josephborromeo/WiCAN/README.md

# WiCAN
ESP32-S3 Based Wireless CAN bus Transceiver and Logger
