josephborromeo/WiCAN/Hardware/WiCAN_V1/WiCAN_BOM.xlsx

Comment | Description | Designator | Footprint | LibRef | Quantity | Manufacturer_Part_Number | Customer Ref | Mult. Qty | QTY Multiplier | 2.5 | WiCAN
CL10B104KB8WPNC | Cap Ceramic 100nF 50V X7R ±10% Pad SMD 0603 +125°C T/R | C1, C4, C10, C11 | FP-CL10-IPC_A | CMP-13271-002353-1 | 4 | CL10B104KB8WPNC | WiCAN C1, C4, C10, C11 | 10
UMK107BJ105KA-T | None | C2 | FP-0603-L_1_6_0_1-W_0_8_0-IPC_A | CMP-2000-05447-3 | 1 | UMK107BJ105KA-T | WiCAN C2 | 3
GRM188R61A226ME15D | Chip Multilayer Ceramic Capacitors for General Purpose, 0603, 22uF, X5R, 15%, 20%, 10V | C3 | FP-GRM188-0_2-IPC_C | CMP-2000-06337-3 | 1 | GRM188R61A226ME15D | WiCAN C3 | 3
CL10A106MQ8NNNC | Cap Ceramic 10uF 6.3V X5R ±20% Pad SMD 0603 +85°C T/R | C5, C6, C8 | FP-CL10-IPC_C | CMP-13271-001938-1 | 3 | CL10A106MQ8NNNC | WiCAN C5, C6, C8 | 8
GRM188R60G226MEA0D | Chip Multilayer Ceramic Capacitors for General Purpose, 0603, 22uF, X5R, 15%, 20%, 4V | C7 | FP-GRM188-0_2-MFG | CMP-2006-02788-2 | 1 | GRM188R60G226MEA0D | WiCAN C7 | 3
CL10A105KO8NNNC | Cap Ceramic 1uF 16V X5R ±10% Pad SMD 0603 +85°C T/R | C9 | FP-CL10-IPC_A | CMP-13271-001457-1 | 1 | CL10A105KO8NNNC | WiCAN C9 | 3
MBRX120LF-TP | DIODE SCHOTTKY 20V 1A SOD123 | D1 | FP-SOD-123-IPC_A | CMP-56206-000012-1 | 1 | MBRX120LF-TP | WiCAN D1 | 3
PESD2CANFD24U-TR | Diode | D2 | SOT95P230X110-3N | PESD2CANFD24U-TR | 1 | PESD2CANFD24U-TR | WiCAN D2 | 3
12V | LED GREEN CLEAR CHIP SMD | D3 | FP-LTST-C190KGKT-MFG | CMP-2000-05197-2 | 1 | 160-1435-1-ND | WiCAN D3 | 3
5V | LED GREEN CLEAR CHIP SMD | D4 | FP-LTST-C190KGKT-MFG | CMP-2000-05197-2 | 1 | 160-1435-1-ND | WiCAN D4 | 3
3V3 | LED GREEN CLEAR CHIP SMD | D5 | FP-LTST-C190KGKT-MFG | CMP-2000-05197-2 | 1 | 160-1435-1-ND | WiCAN D5 | 3
USBLC6-2SC6 | Integrated Circuit | IC1 | SOT95P280X145-6N | USBLC6-2SC6 | 1 | USBLC6-2SC6 | WiCAN IC1 | 3
AZ1117IH-5.0TRG1 | Integrated Circuit | IC2 | SOT230P700X170-4N | AZ1117IH-5.0TRG1 | 1 | AZ1117IH-5.0TRG1 | WiCAN IC2 | 3
USB4105-GF-A | No Description Available | J1 | USB4105_GCT | USB4105-GF-A | 1 | 2073-USB4105-GF-ACT-ND | WiCAN J1 | 3
MEM2067-02-180-00-A_REVB | Micro SD Memory Card ConnectorSMT, Hinged, 1.80mm Profile | J2 | GCT_MEM2067-02-180-00-A_REVB | MEM2067-02-180-00-A_REVB | 1 | 2073-MEM2067-02-180-00-ACT-ND | WiCAN J2 | 3
A-DS_09_PP_Z | Connector | J3 | ADS09PPZ | A-DS_09_PP_Z | 1 | A-DS 09 PP/Z | WiCAN J3 | 3
Solder Jumper |  | JMP1 | Solder Jumper | Solder Jumper | 1 |  | WiCAN JMP1 | 3
STATUS | LED | LED1 | CLMVCFKACL1D1L71BB7C3C3 | CLMVC-FKA-CL1D1L71BB7C3C3 | 1 | CLMVC-FKA-CL1D1L71BB7C3C3 | WiCAN LED1 | 3
RMCF0603JG10K0 | 10kΩ ±5% 0.1W 0603 Thick Film Chip Resistor AEC-Q200 compliant | R1, R5, R6, R7, R8, R9, R10 | FP-RMCF0603-MFG | CMP-26527-000153-1 | 7 | RMCF0603JG10K0 | WiCAN R1, R5, R6, R7, R8, R9, R10 | 18
ERJ-3GEYJ620V |  | R2, R4 | RESC1608X55X30ML15T15 | CMP-1012-00045-2 | 2 | ERJ-3GEYJ620V | WiCAN R2, R4 | 5
RMCF0603FT280R | 280Ω ±1% 0.1W 0603 Thick Film Chip Resistor AEC-Q200 compliant | R3, R12 | FP-RMCF0603-MFG | CMP-26527-006784-1 | 2 | RMCF0603FT280R | WiCAN R3, R12 | 5
ESR03EZPJ751 | 750Ω ±5% 0.25W 0603 Anti-Surge Chip Resistor AEC-Q200 | R11 | FP-ESR03-IPC_B | CMP-08839-029062-1 | 1 | ESR03EZPJ751 | WiCAN R11 | 3
AC0603FR-10100RL | RES 100Ω 1.00% 0.1W 0603 | R13 | FP-AC0603-IPC_A | CMP-03412-011629-2 | 1 | AC0603FR-10100RL | WiCAN R13 | 3
ERJ-P06J121V |  | R14 | RESC2013X70X40LL20T20 | CMP-2001-00481-1 | 1 | ERJ-P06J121V | WiCAN R14 | 3
RESET | Switch | S1 | PTS526SKG15SMTR2LFS | PTS526_SK08_SMTR2_LFS | 1 | PTS526 SK08 SMTR2 LFS | WiCAN S1 | 3
BOOT | Switch | S2 | PTS526SKG15SMTR2LFS | PTS526_SK08_SMTR2_LFS | 1 | PTS526 SK08 SMTR2 LFS | WiCAN S2 | 3
ESP32-S3-WROOM-1-N4 | Integrated Circuit | U1 | ESP32S3WROOM1N4 | ESP32-S3-WROOM-1-N4 | 1 | ESP32-S3-WROOM-1-N4 | WiCAN U1 | 3
AZ1117CR-3.3TRG1 | IC REG LINEAR 3.3V 800MA SOT89 | U2 | FP-SOT89-MFG | CMP-12756-000007-1 | 1 | AZ1117CR-3.3TRG1 | WiCAN U2 | 3
MCP9700T-E/TT | Low-Power Linear Active Thermistor IC, 3-Pin SOT-23, Extended Temperature, Tape and Reel | U3 | SOT-23-TT3_M | CMP-0192-00220-1 | 1 | MCP9700T-E/TT | WiCAN U3 | 3
SN65HVD232D | 3.3 V CAN Transceiver, 17 mA, -40 to 85 degC, 8-pin SOIC (D), Green (RoHS & no Sb/Br) | U4 | D0008A_L | CMP-0315-00073-2 | 1 | SN65HVD232D | WiCAN U4 | 3
