josephborromeo/WiCAN/Hardware/WiCAN_V2/Enclosure/WiCAN_Enclosure_assy.SLDASM

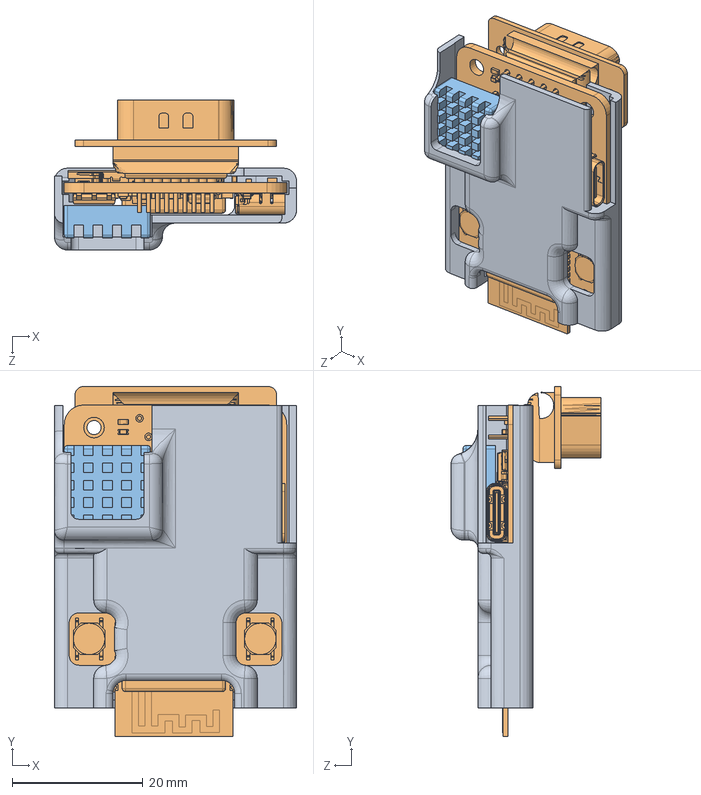
[picture p1: CAD file, 2023-03-30]
Hardware/WiCAN_V2/Enclosure/WiCAN_Enclosure_assy.SLDASM
37.0 x 53.5 x 22.9 mm
WiCAN_Enclosure_Base
WiCAN
Copper_Heatsink
