josephborromeo/WiCAN/Hardware/WiCAN_V2/Enclosure/Copper_Heatsink.SLDPRT

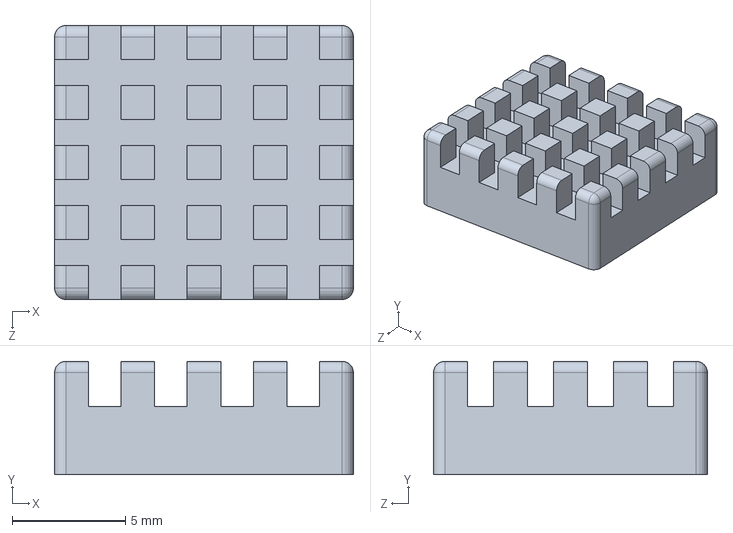
[picture p2: CAD file, 2023-03-30]
Hardware/WiCAN_V2/Enclosure/Copper_Heatsink.SLDPRT
13.2 x 5.00 x 12.1 mm
