josephborromeo/WiCAN/Hardware/WiCAN_V2/Models/MEM2067-02-180-00-A.STEP

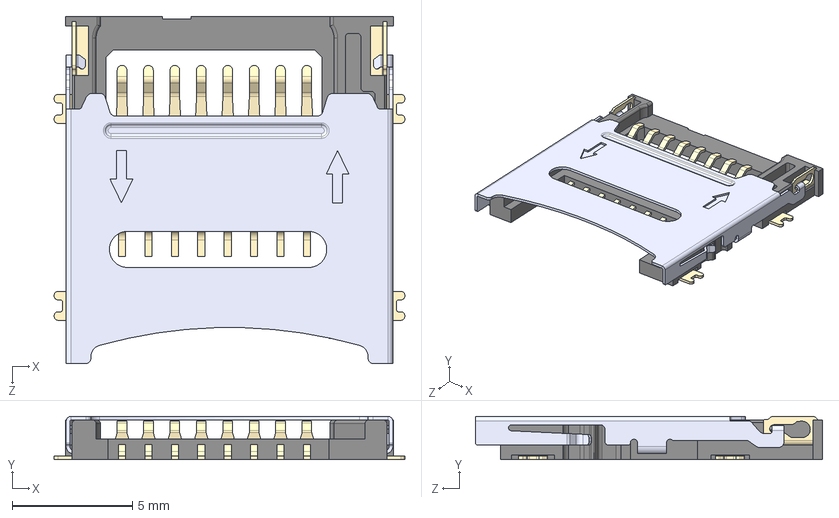
[picture p3: CAD file, 2023-01-06]
Hardware/WiCAN_V2/Models/MEM2067-02-180-00-A.STEP
14.6 x 1.80 x 14.5 mm
