josephborromeo/WiCAN/Hardware/WiCAN_V2/WiCAN_board_outline.dxf

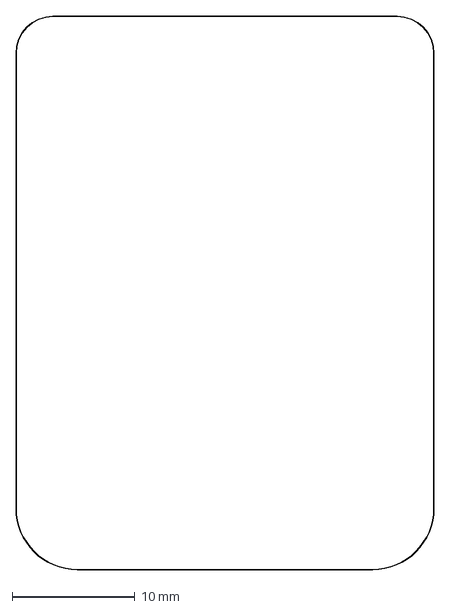
[picture p4: CAD file, 2023-01-06]
Hardware/WiCAN_V2/WiCAN_board_outline.dxf
34.0 x 45.0 mm
