josephborromeo/WiCAN/Hardware/WiCAN_V2/Enclosure/Aluminum_Heatsink.SLDPRT

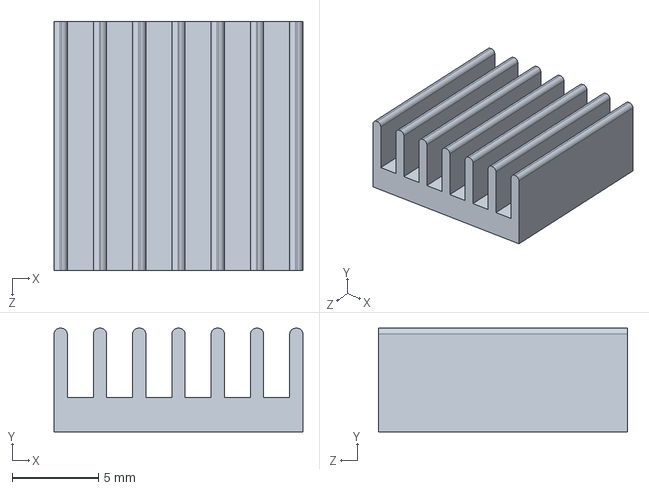
[picture p5: CAD file, 2023-03-30]
Hardware/WiCAN_V2/Enclosure/Aluminum_Heatsink.SLDPRT
14.4 x 6.00 x 14.4 mm
