josephborromeo/WiCAN/Hardware/WiCAN_V2/Models/connector_a-ds_09_pp_z.stp

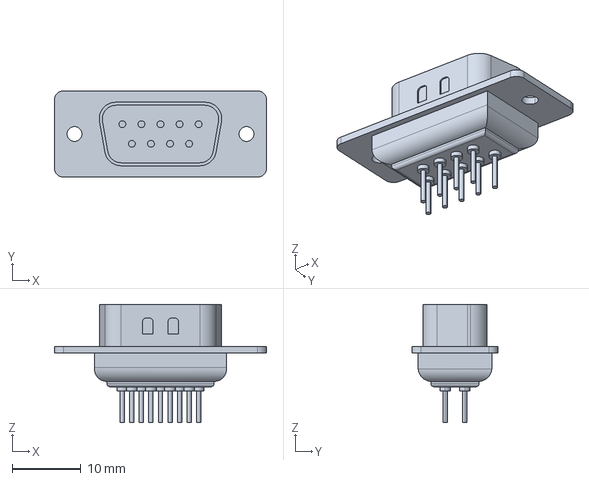
[picture p7: CAD file, 2023-01-06]
Hardware/WiCAN_V2/Models/connector_a-ds_09_pp_z.stp
30.8 x 12.6 x 17.2 mm
