josephborromeo/WiCAN/Hardware/WiCAN_V2/Enclosure/WiCAN_Enclosure_Base.SLDPRT

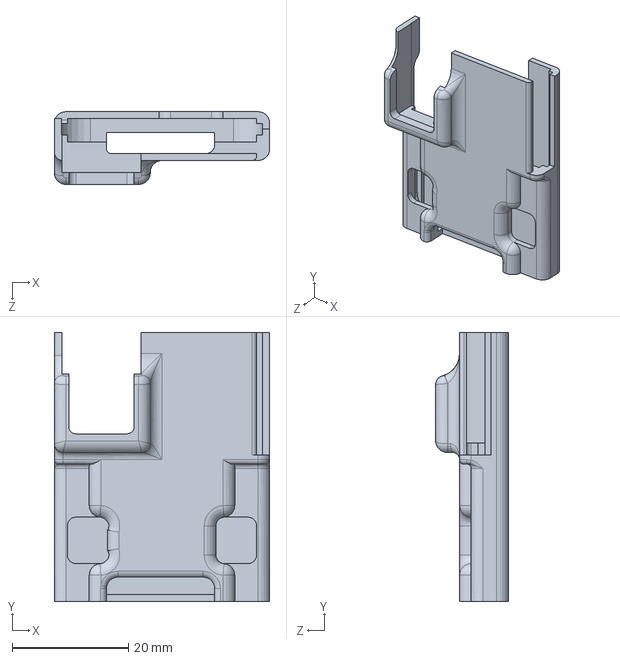
[picture p8: CAD file, 2023-03-30]
Hardware/WiCAN_V2/Enclosure/WiCAN_Enclosure_Base.SLDPRT
37.0 x 46.2 x 12.5 mm
