josephborromeo/WiCAN/Hardware/WiCAN_V2/Models/ESP32-S2-MINI-1-N4.STEP

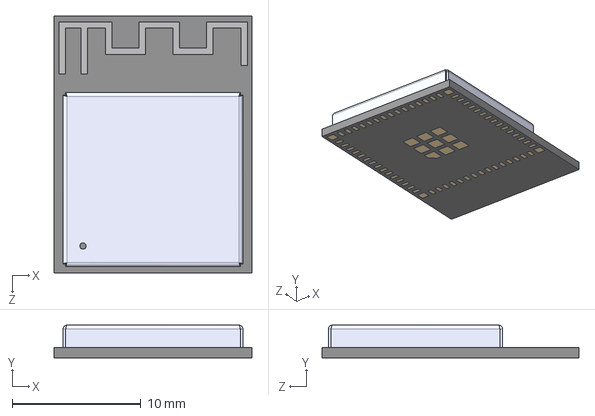
[picture p9: CAD file, 2023-01-06]
Hardware/WiCAN_V2/Models/ESP32-S2-MINI-1-N4.STEP
15.4 x 2.55 x 20.0 mm
