josephborromeo/WiCAN/Hardware/WiCAN_V1/Enclosure/WiCAN_Enclosure_assy.SLDASM

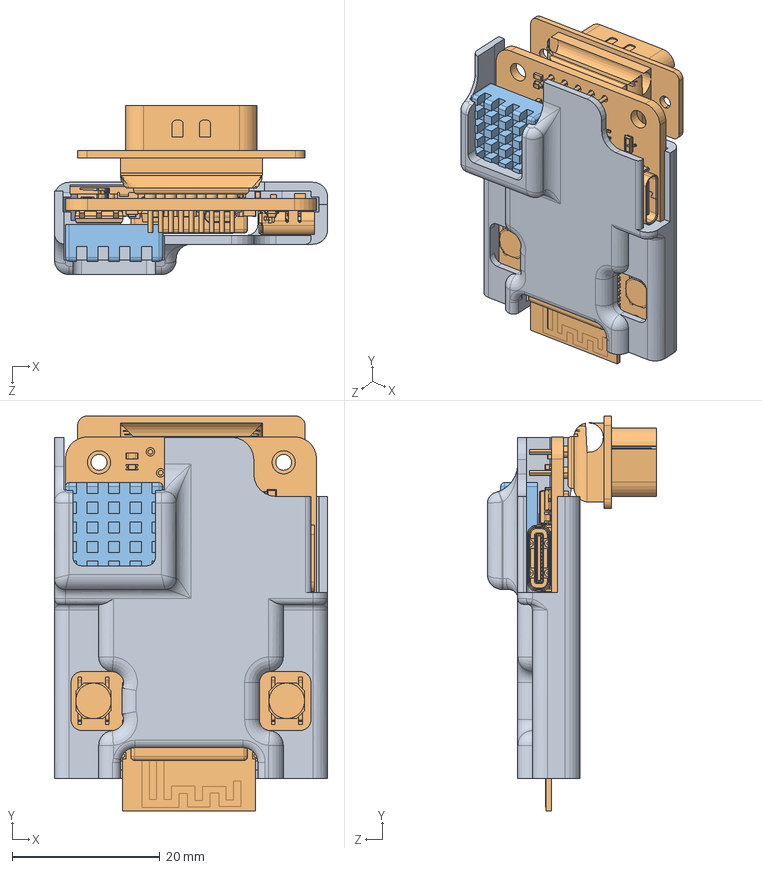
[picture p10: CAD file, 2023-04-18, an earlier design]
Hardware/WiCAN_V1/Enclosure/WiCAN_Enclosure_assy.SLDASM
37.0 x 53.5 x 22.9 mm
WiCAN_Enclosure_Base
WiCAN
Copper_Heatsink
