josephborromeo/WiCAN/Hardware/WiCAN_V1/Enclosure/WiCAN_Enclosure_Base.SLDPRT

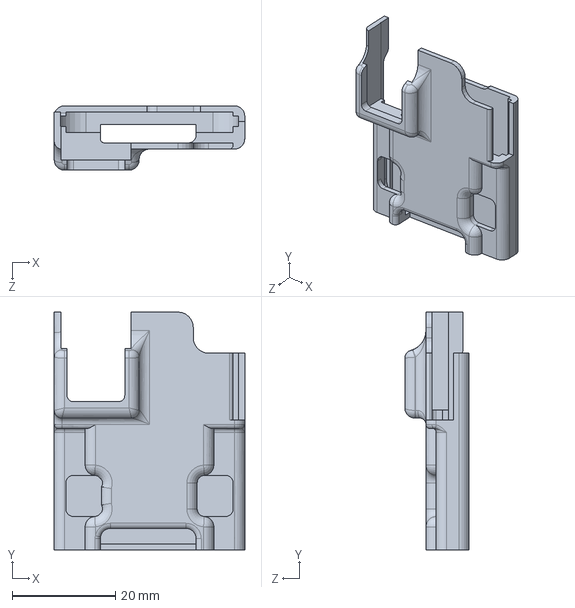
[picture p11: CAD file, 2023-04-18, an earlier design]
Hardware/WiCAN_V1/Enclosure/WiCAN_Enclosure_Base.SLDPRT
37.0 x 46.2 x 12.5 mm
