josephborromeo/WiCAN/(list of files, cad)

Other CAD files:
Hardware/WiCAN_V1/Enclosure/WiCAN_Enclosure_Base.3MF
Hardware/WiCAN_V2/Enclosure/WiCAN_Enclosure_Base.3MF
