josephborromeo/WiCAN/Hardware/WiCAN_V2/WiCAN.pdf

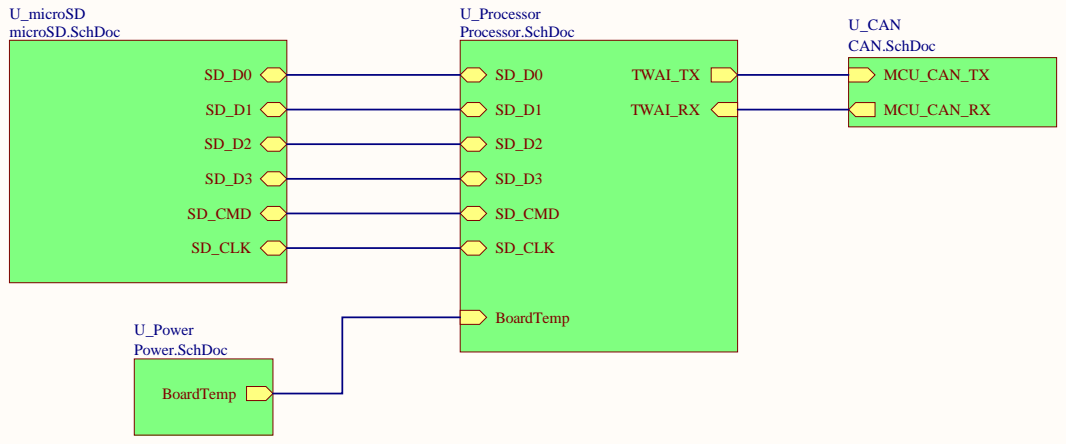
[picture p12: page 1]

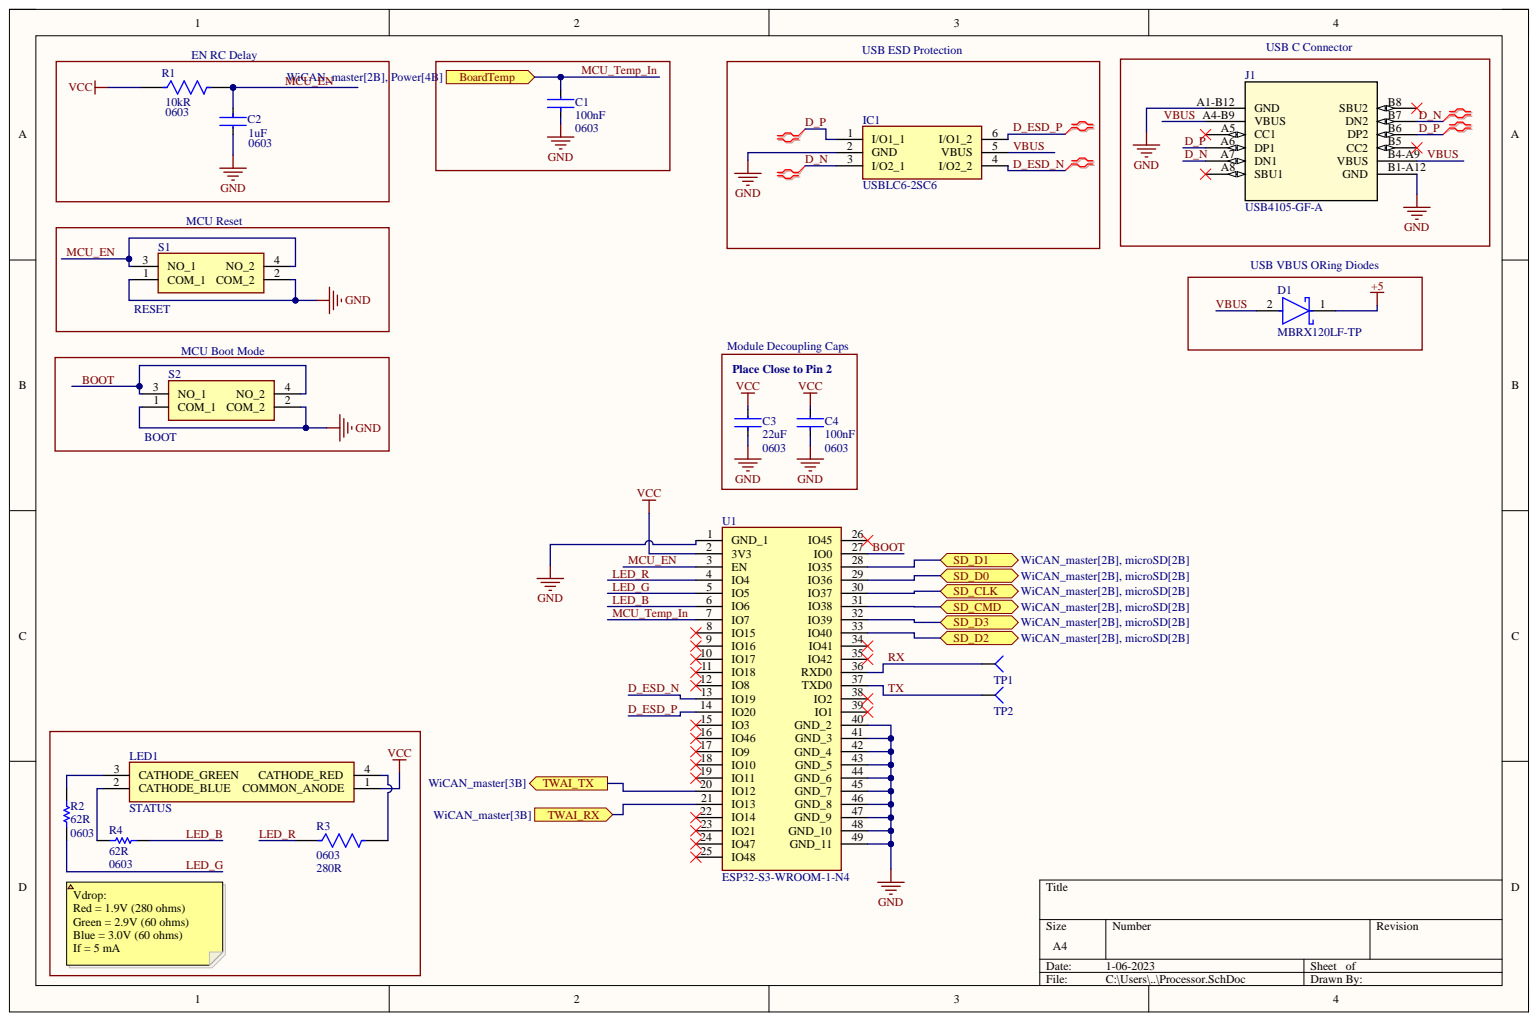
[picture p13: page 2]

USB VBUS ORing Diodes

Place Close to Pin 2

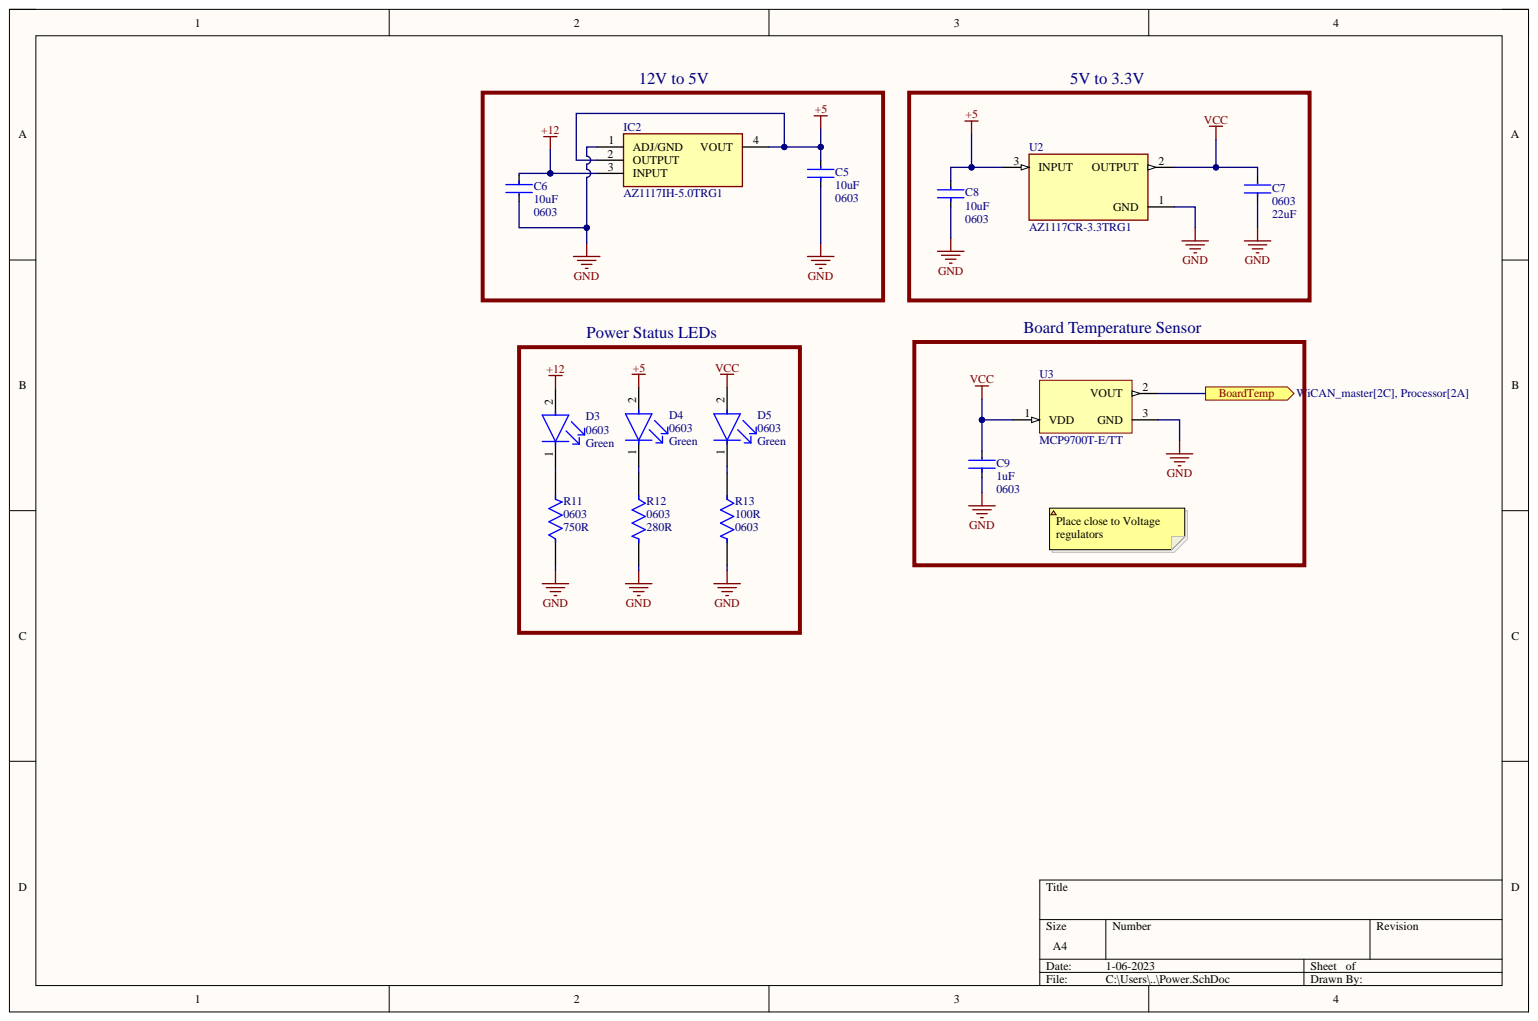
[picture p14: page 3]

Place close to Voltage
regulators

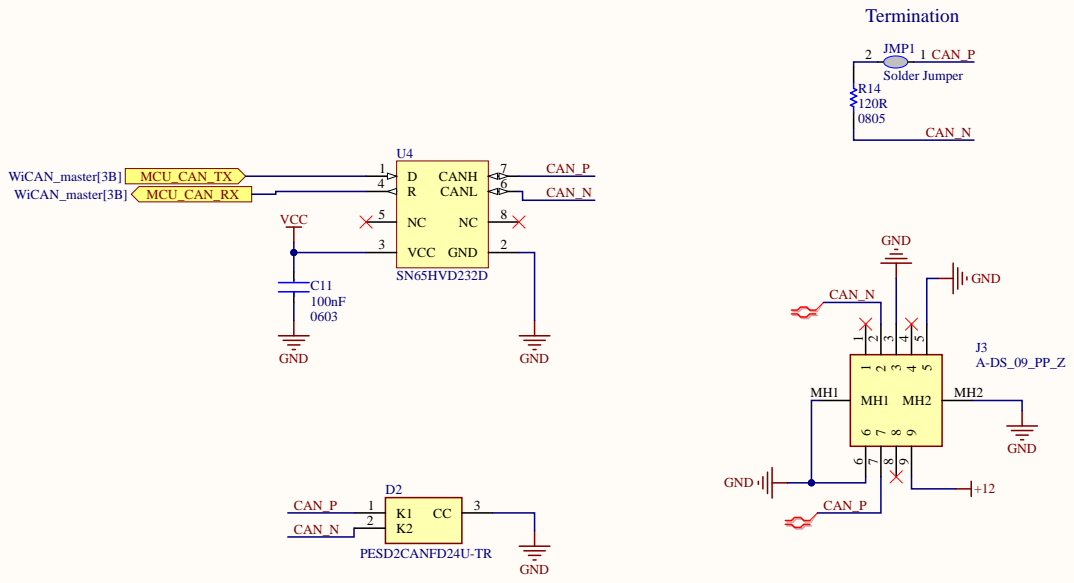
[picture p15: page 4]

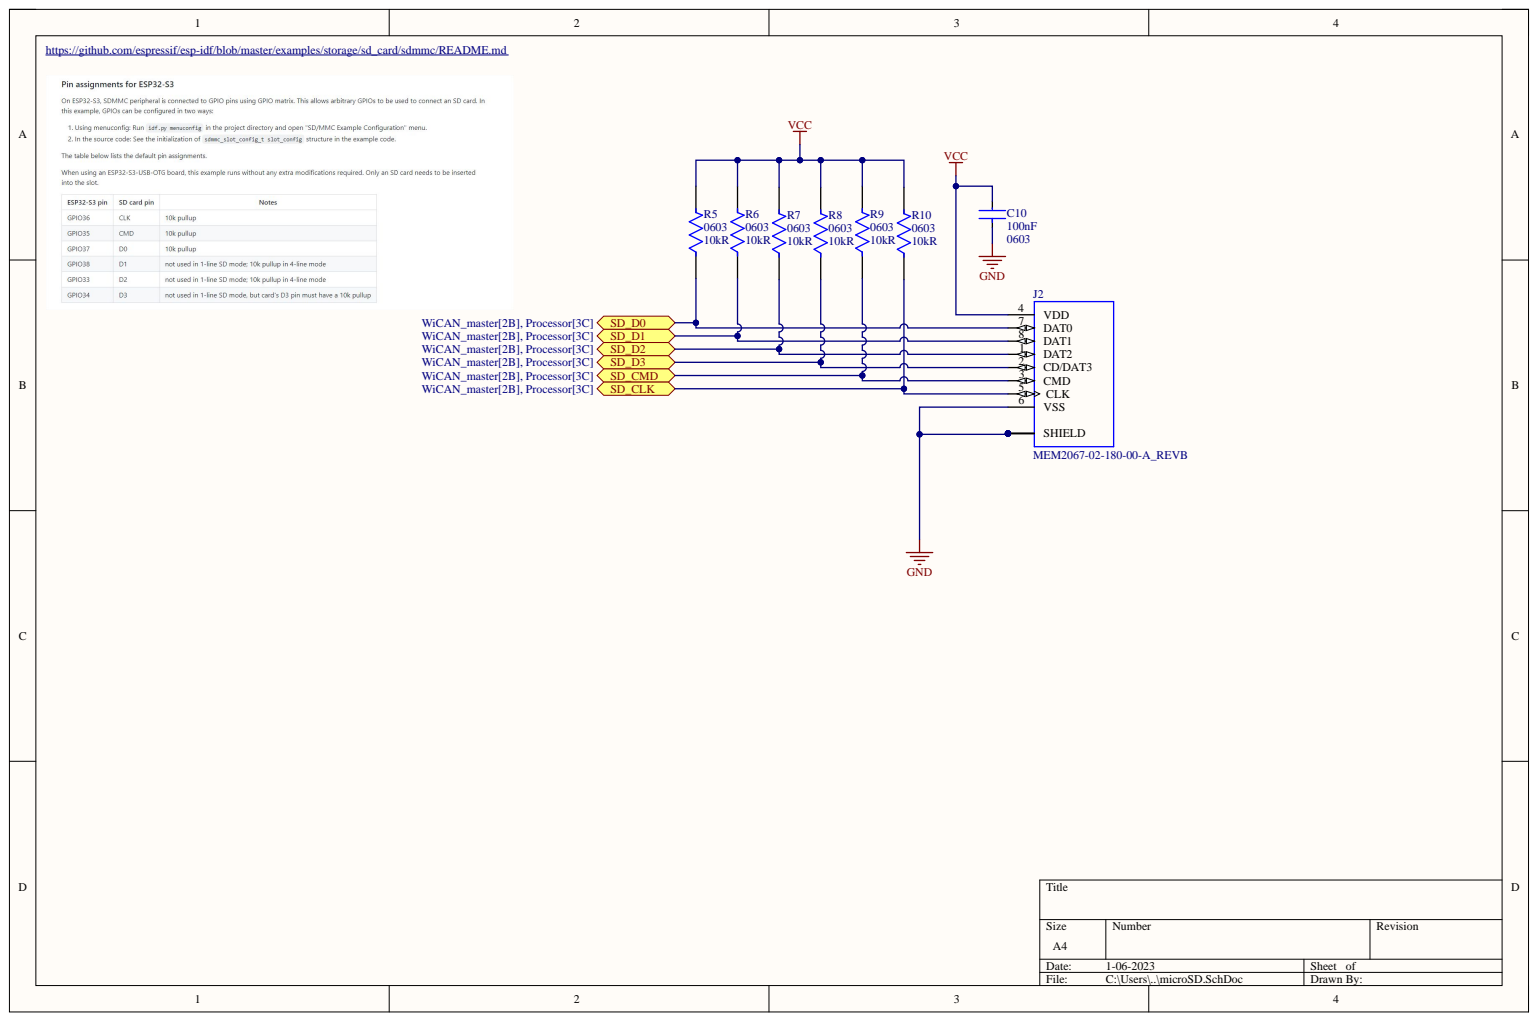
[picture p16: page 5]

https://github.com/espressif/esp-idf/blob/master/examples/storage/sd_card/sdmmc/README.md

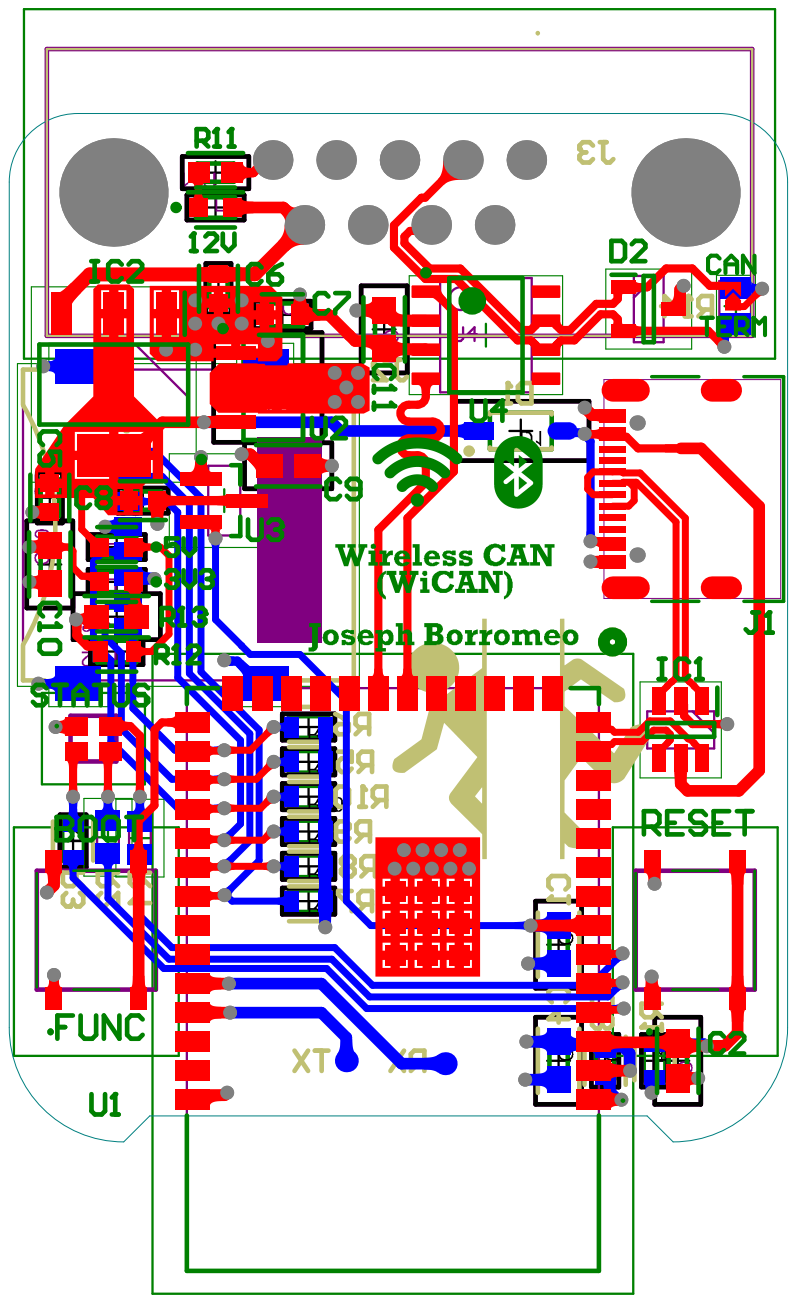
[picture p17: page 6]
