josephborromeo/WiCAN/(list of files, drawings)

Other design files:
Hardware/WiCAN_V1/CAN.SchDoc
Hardware/WiCAN_V1/microSD.SchDoc
Hardware/WiCAN_V1/Power.SchDoc
Hardware/WiCAN_V1/Processor.SchDoc
Hardware/WiCAN_V1/WiCAN.PrjPcb
Hardware/WiCAN_V1/WiCAN_lib.PcbLib
Hardware/WiCAN_V1/WiCAN_lib.SchLib
Hardware/WiCAN_V1/WiCAN_master.SchDoc
Hardware/WiCAN_V2/CAN.SchDoc
Hardware/WiCAN_V2/microSD.SchDoc
Hardware/WiCAN_V2/Power.SchDoc
Hardware/WiCAN_V2/Processor.SchDoc
Hardware/WiCAN_V2/WiCAN.PrjPcb
Hardware/WiCAN_V2/WiCAN_lib.PcbLib
Hardware/WiCAN_V2/WiCAN_lib.SchLib
Hardware/WiCAN_V2/WiCAN_master.SchDoc
