josephborromeo/WiCAN/(commit log)

2023-01-06 Iniital Commit of project files
    [CAN.SchDoc, ESP32-S2-MINI-1-N4.STEP, ESP32-S3-WROOM.step, MEM2067-02-180-00-A.STEP, Power.SchDoc, Processor.SchDoc, WiCAN.PrjPcb, WiCAN_BOM.xlsx]
2023-01-08 LEDC driver and SDMMC driver working
2023-01-28 Fixed SD card mount failure crashing the board. Starting Wifi Setup
    [WiCAN_TX.c, sdmmc_driver.c, wifi.c, wifi.h]
2023-01-31 wireless working - gotta fix ifdefs
    [WiCAN_TX.c, twai_driver.c, wifi.c, wifi.h]
2023-01-31 Fixed conditional compilation for TX and RX boards
    [WiCAN_TX.c, wifi.c]
2023-02-01 Wireless transmission of CAN data successful
2023-02-01 Start of USB driver and CAN messages are wireless
2023-02-10 Fixed some bugs for RX device not initializing correctly if receiving data
    [WiCAN_TX.c, wifi.c, wifi.h]
2023-02-22 wireless CAN is wireless. Trying to get custom USB name now
2023-02-27 Added definition for CAN log format. Added function prototype for logging task
2023-03-15 Transmit CAN from SLCAN to TX board ready for testing
2023-03-15 Wireless CAN messages working!
2023-03-21 SD logging working! Need to fix capital filename/ extension
    [sdmmc_driver.c, sdmmc_driver.h, twai_driver.c]
2023-03-21 Upadted sdkconfig to support long filenames and fix uppercase filenames
    [sdmmc_driver.h]
2023-03-26 trying to fix but where TX crashes with no receivers
    [WiCAN_TX.c, serial_can_parse.py, twai_driver.c, twai_driver.h, wifi.c]
2023-03-28 Started enclosure, started usb storage device
    [WiCAN_Enclosure_Base.3MF, WiCAN_Enclosure_Base.SLDPRT, WiCAN_Enclosure_assy.SLDASM]
2023-03-30 Updated Enclosure files
    [Aluminum_Heatsink.SLDPRT, Copper_Heatsink.SLDPRT, WiCAN_Enclosure_Base.3MF, WiCAN_Enclosure_Base.SLDPRT, WiCAN_Enclosure_assy.SLDASM]
2023-04-16 Improvements to SD writing, switch back to 240 MHz for TX
2023-04-18 PCB REV2 - Schematic Updates mainly done
    [Aluminum_Heatsink.SLDPRT, CAN.SchDoc, Copper_Heatsink.SLDPRT, ESP32-S2-MINI-1-N4.STEP, ESP32-S3-WROOM.step, MEM2067-02-180-00-A.STEP, Power.SchDoc, Processor.SchDoc]
2023-04-18 Older Enclosure, not commited
    [WiCAN_Enclosure_Base.3MF, WiCAN_Enclosure_Base.SLDPRT, WiCAN_Enclosure_assy.SLDASM]
2023-04-18 PCB Update - need to finish layout + routing
    [CAN.SchDoc, Power.SchDoc, Processor.SchDoc, WiCAN.PrjPcb, WiCAN_lib.PcbLib, WiCAN_lib.SchLib]
